meimei-lin/Arduino-Final-Progect/README.md

### 計算機組織及微算機實驗
#### test1
* 循跡行走
#### test2
* 避障
#### test3
* 循跡行走+避障
#### 作品介紹
* 本作品在設計一台具有循跡與避障功能的自走車，利用撰寫Arduino程式控制自走車能夠沿著黑線行走，完成循跡的功能。另外，使用超音波測距模組與紅外線反射模組實現在遇到障礙物時能夠即時繞過障礙物，並繼續前進完成循跡。
#### 成果照片
